fboundy/ssid_map/hardware/bezel/back.stl

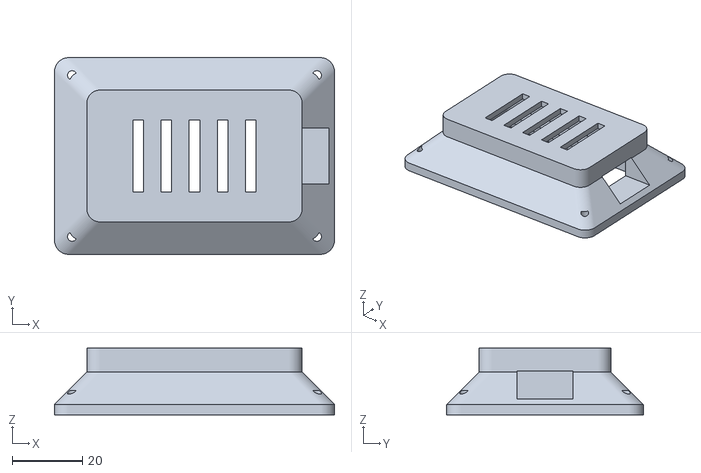
[picture p1: CAD file, 2026-09-28]
hardware/bezel/back.stl
79.6 x 55.9 x 19.0
