fboundy/ssid_map/hardware/fan-grille/fan_grille_40.stl

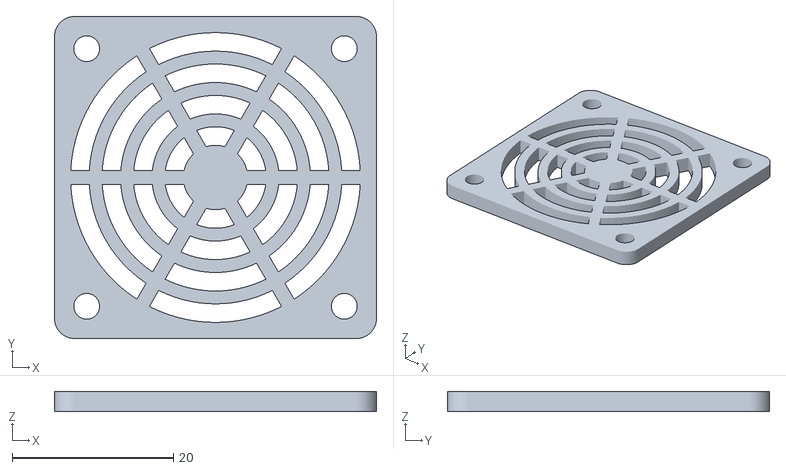
[picture p2: CAD file, 2026-09-30]
hardware/fan-grille/fan_grille_40.stl
40.0 x 40.0 x 2.50
