fboundy/ssid_map/hardware/bezel/front.stl

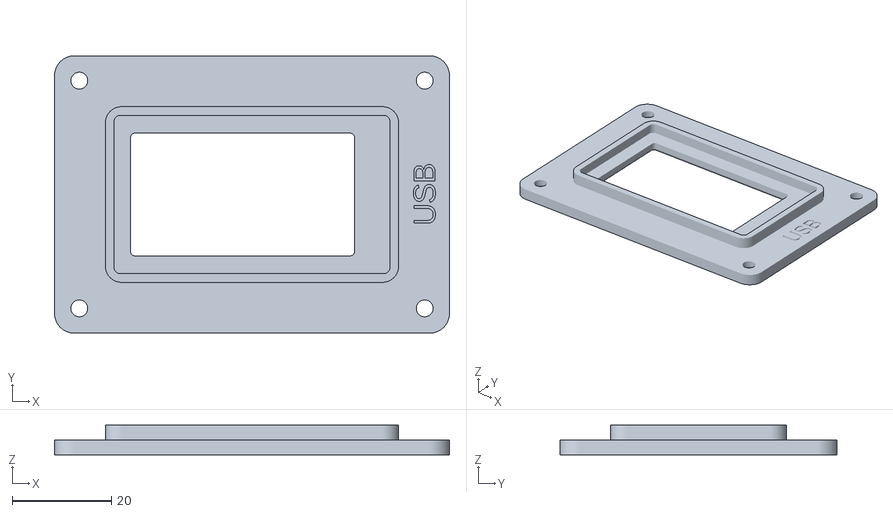
[picture p3: CAD file, 2026-09-28]
hardware/bezel/front.stl
79.6 x 55.9 x 6.00
