fboundy/ssid_map/hardware/bezel/panel_cutout.dxf

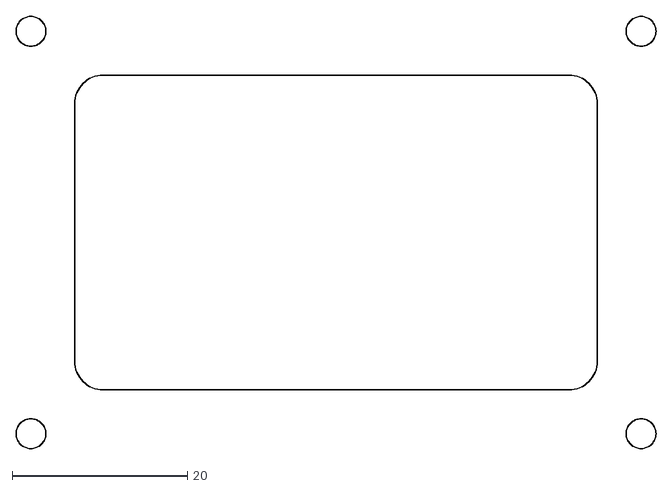
[picture p4: CAD file, 2026-09-27]
hardware/bezel/panel_cutout.dxf
73.0 x 49.3
