fboundy/ssid_map/(commit log)

2026-09-21 ESP32-S3 Wi-Fi selector and NAT router (Penrith MRT Xebro)
    Native ESP-IDF 5.4 firmware for the Sparkle IoT ESP32-S3 N16R8. Advertises
    a single AP with a web UI to pick upstream SSIDs (stored in NVS), joins the
    strongest one after a 60 s boot grace period and NATs AP clients through it.
    Over-ride SSIDs suppress routing while in range; AP subnet is configurable
    (default 192.168.137.0/24). Captive/forwarding DNS proxy on the AP side.
    The earlier Arduino-core implementation is kept under arduino/.
    [partitions.csv]
2026-09-22 Add Waveshare ESP32-S3-Touch-LCD-1.9 target with LCD status page
    New PlatformIO env ws_touch_lcd_19 (-DXEBRO_DISPLAY_WS19) drives the board's
    ST7789 over SPI via esp_lcd and shows mode, connected uplink SSID/IP/RSSI/NAT
    state and the AP's connected clients (lease IP + MAC), refreshed once a second.
    No touch handling. Bitmap fonts are generated from Consolas with GDI+.
2026-09-22 LCD: send Waveshare panel tuning registers, PWM backlight, 40 MHz SPI
    The ST7789 on the Touch-LCD-1.9 showed nothing with only the IDF driver's
    generic init. Send the vendor's porch/gate/VCOM/power/gamma sequence after
    init (as batmon_waveshare does), drive the backlight with LEDC and use a
    solid-colour splash so driving and backlight faults look different.
2026-09-22 Waveshare build: hourly Ookla speed test shown on the LCD and web page
    Picks the nearest speedtest.net server over HTTPS, then runs a 6 s HTTP
    download and a sized upload against its port-8080 endpoints (raw sockets,
    single stream). Triggered 5 s after the uplink comes up, hourly while
    routing, and from a Speed test button on the web page. Result replaces the
    NAT-state slot on the LCD uplink line. Only built with -DXEBRO_SPEEDTEST
    (ws_touch_lcd_19 env); the Sparkle build is unchanged.
    [config.example.h, display.cpp, main.cpp, speedtest.cpp, speedtest.h, web_ui.cpp]
2026-09-26 Simplify the LCD to uplink + named host; add a named host to the setup page
    Top half of the screen is now "Connected to:" with the SSID and the speed
    test as down/up arrows, replaced by a no-entry symbol and "No Internet" when
    there is no working uplink, or by "Over-ridden by <SSID>" when an over-ride
    is in range. Bottom half shows "<name> Connected" for a single named host,
    set from the web page by picking a connected client or typing a MAC and
    naming it (setting a new one replaces it). The name is a label only and does
    not gate routing. The AP client list moved into the app snapshot so the web
    page and the LCD share it.
    [app.h, display.cpp, main.cpp, store.cpp, store.h, web_ui.cpp]
2026-09-26 LCD: bigger SSID type, speeds in a right-hand column
    Adds 36 px XL and 20 px medium faces so the SSID and named-host lines step
    down through four sizes instead of collapsing to the small font. Speeds move
    to a fixed right column with both arrows left-aligned so they line up
    whatever the figures' widths, and "No Internet" wraps to two lines to stay
    clear of the edge. The font generator moves into tools/, joined by
    preview_lcd.py which renders the layout to a PNG from fonts.h for checking
    spacing without hardware.
    [display.cpp]
2026-09-26 LCD: label both halves and lay the device half out like the uplink half
    "Connected to:" becomes "Internet Connection:", and the bottom half now
    mirrors the top: a small label and the device name on the left, with a
    status block on the right - a green tick over "Connected" or a red no-entry
    symbol over "Not Connected".
2026-09-26 Add a parametric panel-mount bezel for the Waveshare board
    Two printed parts that sandwich the module and the panel: a front bezel
    holding a 2 mm protective sheet and the cover glass, and a back clamp whose
    ribs press on the bare strips of the PCB to push the module forward. Four M3
    countersunk screws from the front. Open at the rear so the USB-C socket,
    headers and battery lead stay reachable from inside the panel.
    Dimensions are from Waveshare's own drawing (the -DAD.rar download), not the
    wiki images. Ships as OpenSCAD source plus front/back STLs and a DXF of the
    panel cutout; panel thickness is a parameter, good to 6.8 mm.
    [back.stl, bezel.scad, front.stl, panel_cutout.dxf]
2026-09-27 Bezel: use the measured module dimensions and offset the window
    Glass 55.10 wide, cover glass 2.54, glass front to PCB back 7.83, and 17.50
    to the pin tips. Protective sheet is now 1 mm.
    The window is cut to the measured clear aperture (44.70 x 24.30) rather than
    the active pixel area, and shifted 1.9 mm off centre to match it - scaled
    off the Waveshare front view, where the aperture sits nearer the end away
    from the USB-C socket. va_off_x makes that adjustable; the README says how
    to check it against the board before printing.
    [back.stl, bezel.scad, front.stl, panel_cutout.dxf]
2026-09-27 Bezel: mark the USB end on both parts
    The window offset is confirmed against the board - the wide border is at the
    USB end - so the geometry is unchanged. But that makes both parts handed
    (the window is offset and the ribs dodge the buttons at one end only), and
    nothing on them said which way round. Both now carry "USB" debossed into the
    back face at that end.
    [back.stl, bezel.scad, front.stl]
2026-09-28 Bezel: move the ribs off the BOOT/RST buttons, box in the pin headers
    The rib feet were catching the buttons at the USB end, so they now start at
    x = -8 instead of -14.
    The back part becomes a box 19 mm deep that encloses the pin headers, with
    1.5 mm under the lid. Its walls flare out to the panel flange at 45 degrees
    so it prints lid-down without supports, and it has a 16 x 8 mm slot for the
    USB-C plug plus vent slots in the lid. The separate screw bosses are gone -
    the flare gives 7 mm of material to tap into.
    [back.stl, bezel.scad]
2026-09-28 Rotate the screen 180 and mirror the bezel: USB-C now on the left
    LCD_ROTATE_180 flips the panel's mirror axes. The 170 px axis sits centrally
    in the ST7789's 240 columns, so the 35 px gap is unchanged either way.
    The bezel has to follow, since its window offset, bearing ribs and USB slot
    are all referenced to that end: usb_left mirrors both parts on output, with
    the "USB" lettering counter-mirrored so it still reads.
    [back.stl, bezel.scad, front.stl]
2026-09-28 Bezel: keep the rib legs off the BOOT/RST buttons
    The rib feet already stopped short of the buttons, but the legs still ran the
    full width of the module and caught them: the actuators stand ~1 mm off the
    PCB and overhang its edge, and the legs sat only 0.5 mm outside that edge.
    The legs now span the same range as the feet, so no part of the rib passes
    over that end of the board, and the edge clearance goes to 1.0 mm. Back part
    only - the front is unchanged.
    [back.stl, bezel.scad]
2026-09-29 Connect on boot as soon as the first scan lands, with no grace period
    The 60 s countdown before auto-connecting is gone: with saved networks the
    device now goes straight into retry, which joins the strongest visible one
    the moment the boot scan completes. Measured 6.9 s from power-on to routing,
    against about 64 s before. Selecting the first network from an idle device
    now connects immediately too.
    Scanning is unchanged - the boot scan still runs, the list still refreshes
    every 30 s while not routing, and the list can be amended at any time from
    the web page.
2026-09-29 LCD: show the named device's lease IP under its name
    Caps that name at the 22 px face so the extra line always fits: label at
    +6, name at +26, IP at +56, ending 5 px clear of the screen edge. Shows
    "no lease yet" if the device is associated but has not taken an address.
2026-09-30 Add a printable 40 mm fan grille
    Concentric-ring finger guard on the standard 40 mm pattern: 40 mm square,
    four 3.2 mm holes on 32 mm centres, 36 mm aperture with three rings and six
    spokes. Rings are spread evenly between hub and aperture, so changing the
    count or the fan size needs no hand-fitting - table of other sizes in the
    README.
    [fan_grille.scad, fan_grille_40.stl]
2026-09-30 Add a fan grille cut as the Penrith MRT badge
    Alternative to the plain ring guard, same 40 mm mounting. The roundel is read
    as solid-where-purple, open-where-white: the mountain outline and the cross
    were traced from the team's artwork and normalised to the badge's inner disc,
    so it scales from one parameter.
    The lettering is engraved rather than cut, because cutting it drops the
    counters of O, A, R and P out as loose islands, and the roundel's white
    outline is omitted for the same reason. Two arc slots in the plain lower
    quarters claw back some airflow: 30 % open against 52 % for the plain rings,
    which the README states so the choice is informed.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
    [fan_grille_40_pmrt.stl, fan_grille_pmrt.scad]
2026-10-20 Drive every user-visible name from AP_SSID; drop the Arduino port and the badge grille
    AP_SSID already named the access point, but the web page's title and heading,
    the boot banner and the speed-test user agent each spelled the name out
    again, so changing it renamed only half the device. They now all take it from
    the one define - verified by building with a different SSID and confirming the
    old name is absent from the image and the new one appears in all four places.
    AP_SSID and AP_PASS are also now length-checked at compile time.
    Removes arduino/, which the IDF build superseded, and the PMRT badge fan
    grille.
    [fan_grille_40_pmrt.stl, fan_grille_pmrt.scad]
2026-10-20 Add a parts list
    Everything for one panel-mounted unit: board, sheet and fastener sizes, the
    panel cutout, the fan hardware and print orientations, drawn from the figures
    already in the hardware READMEs. Also records what is deliberately not used -
    the board's M2 holes, the battery connector and the card slot.
2026-10-20 Document the system: setup procedure, sourced parts list, example config
    The README now says what the box actually is - the Wi-Fi router between the
    vehicle uplink and the client radio gateway - rather than describing the
    firmware in isolation.
    An in-vehicle setup procedure, with a
    table of what the display shows when something is wrong. The photographs from
    the original PDF are not reproduced; the file says so.
    hardware/PARTS.md gains every item with its supplier link, part number and
    price, and flags three things worth settling: the Pi Hut link selects the
    No-Touch board, which has no IPEX antenna pad; the fan is 12 V and 20 mm deep;
    and the RF chain's two ends are not recorded anywhere.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
    [config.example.h]
2026-10-20 Parts list: specify the With-Touch board, which is the one the bezel fits
    Waveshare sell two mechanically different boards under one name and the link
    pointed at the cheaper No-Touch one. Their own drawings differ throughout:
    51.00 x 26.00 PCB against 52.60 x 29.00, and no overhanging cover glass at
    all - the LCD module sits inside the PCB outline rather than 1.2 mm proud of
    it. The bezel works by trapping that glass, so the No-Touch board would sit
    in the pocket with 2 mm of slop per side and nothing to seal against.
    Bezel unchanged; its README already names the Touch variant.
2026-10-20 Parts list: record the antenna chain and the TNC polarity check
    The RF assemblies feed the Simoco SDM730. Notes that the pigtail is RP-TNC
    rather than TNC, which screws onto a conventional TNC jack just as tightly
    while making no centre contact, and gives the pin-or-hole check that tells
    them apart along with the conventional-polarity part number.
2026-10-20 Parts list: the RP-TNC pigtail is correct - the SDM730's port is RP-TNC
    Confirmed working on the vehicle. Keeps a short note the other way round,
    since a conventional TNC replacement would screw on identically and pass
    nothing.
2026-10-20 Generalise the operational detail ahead of publishing
    Takes out the team's in-vehicle procedure and the specific uplink SSIDs; the
    README and parts list now describe what the device does rather than where it
    is deployed. The firmware is unchanged.
2026-10-20 Rewrite the README for someone arriving at it cold
    The old one was written as notes to self: telegraphic, heavy on tables of
    bare facts, and it opened by naming the access point even though that name is
    a config.h setting. Replaces it with prose that explains what the device is
    for and why it behaves as it does, keeping every technical fact but giving
    each one its reason.
    The device name now appears only as the stated default of AP_SSID, and the
    title describes the thing rather than naming one deployment. Adds a contents
    line, states the measured throughput and the data cost of the speed test up
    front, and moves the Windows build problems to the end, flagged as
    environment issues rather tha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
